hatlabs/SH-ESP32-hardware/SH-ESP-HAT-Proto/SH-ESP32-HAT-Proto.kicad_pcb

## KiCad design SH-ESP-HAT-Proto/SH-ESP32-HAT-Proto.kicad_pcb (2023-08-08)

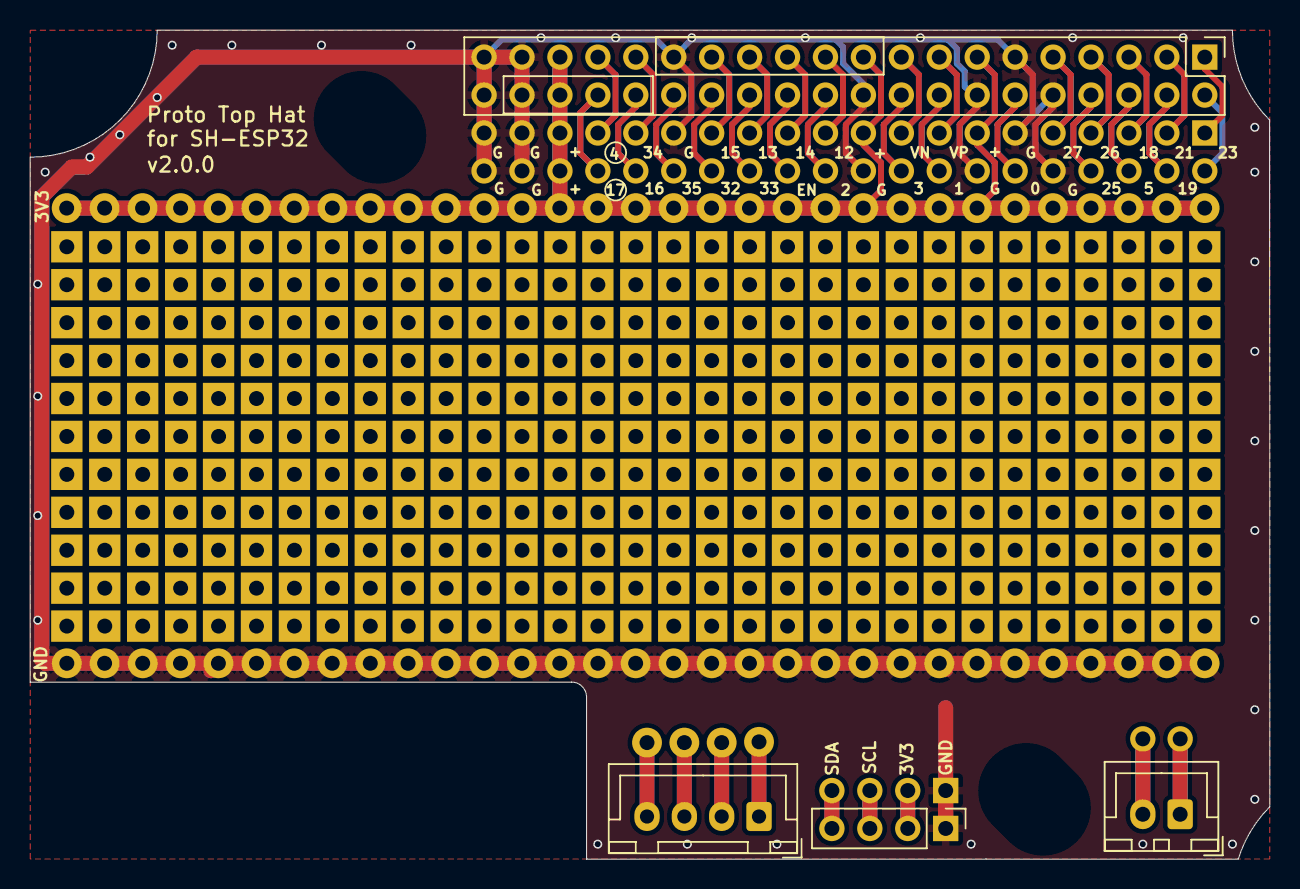
[picture p12: board SH-ESP32-HAT-Proto.kicad_pcb from above]

Board: 2 copper layers, 83.0 x 55.5 mm, 14 parts (1 on the bottom side), 38 nets.

Parts:
H1001, H1002: MountingHole; MountingSlot_3.2mm_M3_Unplated
J301: Conn_01x02; JST_XH_B2B-XH-A_1x02_P2.50mm_Vertical
J302, J307: GPIO; PinHeader_2x20_P2.54mm_Vertical
J303, J305: I2C; PinHeader_1x04_P2.54mm_Vertical
J306: Conn_01x04; JST_XH_B4B-XH-A_1x04_P2.50mm_Vertical
P301, P302, P303, P304, P305, P306: Conn_01x01_Male; ProtoPad-Drill1mm

Connections:
+3V3: J302.13, J302.19, J302.35, J302.36, J307.13, J307.19, J307.35, J307.36
/IOHeader/3V3: J303.2, J305.2
/IOHeader/EN: J302.24, J307.24
/IOHeader/IO0: J302.12, J307.12
/IOHeader/IO2: J302.22, J307.22
/IOHeader/IO4_C: J302.33, J307.33
/IOHeader/IO5: J302.6, J307.6
/IOHeader/IO12: J302.21, J307.21
/IOHeader/IO13: J302.25, J307.25
/IOHeader/IO14: J302.23, J307.23
/IOHeader/IO15: J302.27, J307.27
/IOHeader/IO16_C_SDA: J302.32, J307.32
/IOHeader/IO17_C_SCL: J302.34, J307.34
/IOHeader/IO18: J302.5, J307.5
/IOHeader/IO19: J302.4, J307.4
/IOHeader/IO21: J302.3, J307.3
/IOHeader/IO22: J302.2, J307.2
/IOHeader/IO23: J302.1, J307.1
/IOHeader/IO25: J302.8, J307.8
/IOHeader/IO26: J302.7, J307.7
/IOHeader/IO27: J302.9, J307.9
/IOHeader/IO32_C: J302.28, J307.28
/IOHeader/IO33_C: J302.26, J307.26
/IOHeader/IO34_C: J302.31, J307.31
/IOHeader/IO35_C: J302.30, J307.30
/IOHeader/RXD0_C: J302.18, J307.18
/IOHeader/SCL: J303.3, J305.3
/IOHeader/SDA: J303.4, J305.4
/IOHeader/SENSOR_VN: J302.17, J307.17
/IOHeader/SENSOR_VP: J302.15, J307.15
/IOHeader/TXD0_C: J302.16, J307.16
GND: J302.10, J302.11, J302.14, J302.20, J302.29, J302.37, J302.38, J302.39, J302.40, J303.1, J305.1, J307.10, J307.11, J307.14, J307.20, J307.29, J307.37, J307.38, J307.39, J307.40
unnamed: J301.1, P301.1
unnamed: J301.2, P302.1
unnamed: J306.1, P303.1
unnamed: J306.2, P304.1
unnamed: J306.3, P305.1
unnamed: J306.4, P306.1
