hatlabs/SH-ESP32-hardware/SH-ESP-HAT-Blank/SH-ESP32-Blank.kicad_pcb

## KiCad design SH-ESP-HAT-Blank/SH-ESP32-Blank.kicad_pcb (2020-12-20)

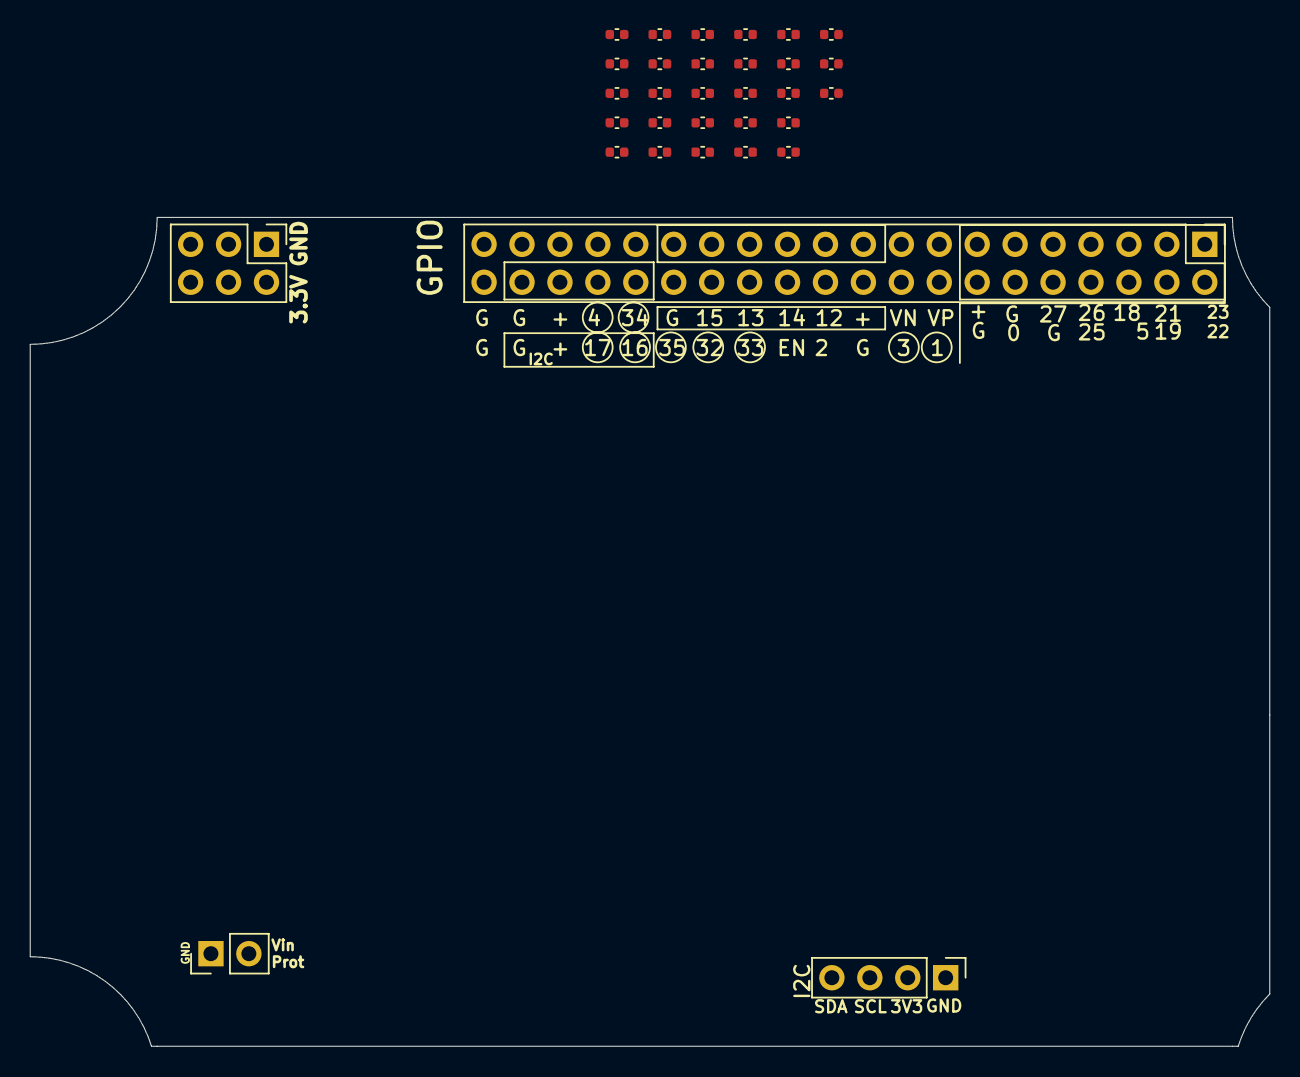
[picture p13: board SH-ESP32-Blank.kicad_pcb from above]

Board: 4 copper layers, 83.0 x 55.5 mm, 34 parts (0 on the bottom side), 2 nets, no tracks yet.

Parts:
C1001, C1002, C1003, C1004, C1005, C1006, C1007, C1008, C1009, C1010, C1011, C1012, C1013, C1014, C1015, C1016, C1017, C1018, C1019, C1020, C1021, C1022, C1023, C1024, C1025, C1026, C1027, C1028: 100nF; C_0402_1005Metric
H1001, H1002: MountingHole; MountingSlot_3.2mm_M3_Unplated
J302: GPIO; PinHeader_2x20_P2.54mm_Vertical
J303: I2C; PinHeader_1x04_P2.54mm_Vertical
J304: Conn_01x02; PinHeader_1x02_P2.54mm_Vertical
J305: Power; PinHeader_2x03_P2.54mm_Vertical

Connections:
+3V3: C1001.2, C1002.2, C1003.2, C1004.2, C1005.2, C1006.2, C1007.2, C1008.2, C1009.2, C1010.2, C1011.2, C1012.2, C1013.2, C1014.2, C1015.2, C1016.2, C1017.2, C1018.2, C1019.2, C1020.2, C1021.2, C1022.2, C1023.2, C1024.2, C1025.2, C1026.2, C1027.2, C1028.2, J302.13, J302.19, J302.35, J302.36, J303.2, J305.2, J305.4, J305.6
GND: C1001.1, C1002.1, C1003.1, C1004.1, C1005.1, C1006.1, C1007.1, C1008.1, C1009.1, C1010.1, C1011.1, C1012.1, C1013.1, C1014.1, C1015.1, C1016.1, C1017.1, C1018.1, C1019.1, C1020.1, C1021.1, C1022.1, C1023.1, C1024.1, C1025.1, C1026.1, C1027.1, C1028.1, J302.10, J302.11, J302.14, J302.20, J302.29, J302.37, J302.38, J302.39, J302.40, J303.1, J304.1, J305.1, J305.3, J305.5
