hatlabs/SH-ESP32-hardware/(notices)

Notices in the files:
SH-ESP-HAT-Blank/SH-ESP32-Blank.sch:
https://creativecommons.org/licenses/by-sa/4.0
Sailor Hat for ESP32 is licensed under CC BY-SA 4.0.
SH-ESP-HAT-Proto/SH-ESP32-HAT-Proto.kicad_sch:
This work is licensed under CC BY-SA 4.0.
PCB.kicad_sch:
SH-ESP32 is licensed under CC BY-SA 4.0.
